haapjuu/monproj/(commit log)

2020-03-17 Added nappimoottori.ino to test that the motor works
2020-03-18 Made basicfunctions.ino move the servo, the loop needs working.
2020-03-19 Moved the test for keypad and servo to keypadmotor.ino. Keeping basicfunctions.ino for implementing more features.
2020-03-19 Made a pin code to "unlock" the lock
2020-03-24 keypad servo test file
2020-03-24 Moved keypad_servo_test.ino to a project folder. Added "Serial.begin(9600);" and "Serial.println" -lines for debugging to keypad_servo_test.ino.
2020-03-26 Deleted duplicate serial print of "Locking"
2020-04-06 Added Radio.ino for Arduino: trying to learn to use the radiotransmitter.
2020-04-06 Added Radio.ino for Arduino, used for sending messages to the Raspberry Pi. Added ReceiveArduino.py for Raspberry Pi, used for receiving messages from the Arduino.
2020-04-13 Fixed radio address on both sending and receiving ends
    [ReceiveArduino.py]
2020-04-15 Changed CE GPIO PIN from 17 to 26
2020-04-15 Created accesscontrol.ino where we combine all of the earlier code snippets for a final file for Arduino.
2020-04-16 Changed sleep time in ReceiveArduino.py. Changed servo angles in accesscontrol.ino. Trying to make the Raspberry Pi receive all of the messages sent by the Arduino.
2020-05-02 Testing new solenoid lock.
2020-05-13 Commenting out added parts to find out what broke the code
    [ReceiveArduinoTest.py]
2020-05-13 Added tests for servo
2020-05-13 Added keypad - servo test code
2020-05-13 Added to configuring Raspberry Pi
2020-05-13 Update README.md
    added 1.5 servo wip
2020-05-13 Added schematic for nappimoottori.ino
2020-05-13 Added image of schematic of nappimoottori.ino
2020-05-13 1.1 servo dropdown
2020-05-13 1.3 servo keypad dropdown
2020-05-13 Added schematic for keypad.ino
2020-05-13 Added schematic for 1.2
2020-05-13 Added schematic for keypad_servo_test.ino
2020-05-13 Added schematic to 1.3
2020-05-13 Added schematic for Raspberry pi & NRF24L01+
2020-05-13 Renamed schematic
2020-05-13 Added image of Raspberry Pi with the radio module
2020-05-13 Added final schematic
